piotrcurious/attiny-car-fan-control/Screenshot_2021-04-04-12-01-27-680_com.ecstudiosystems.electriccircuitstudio.jpg

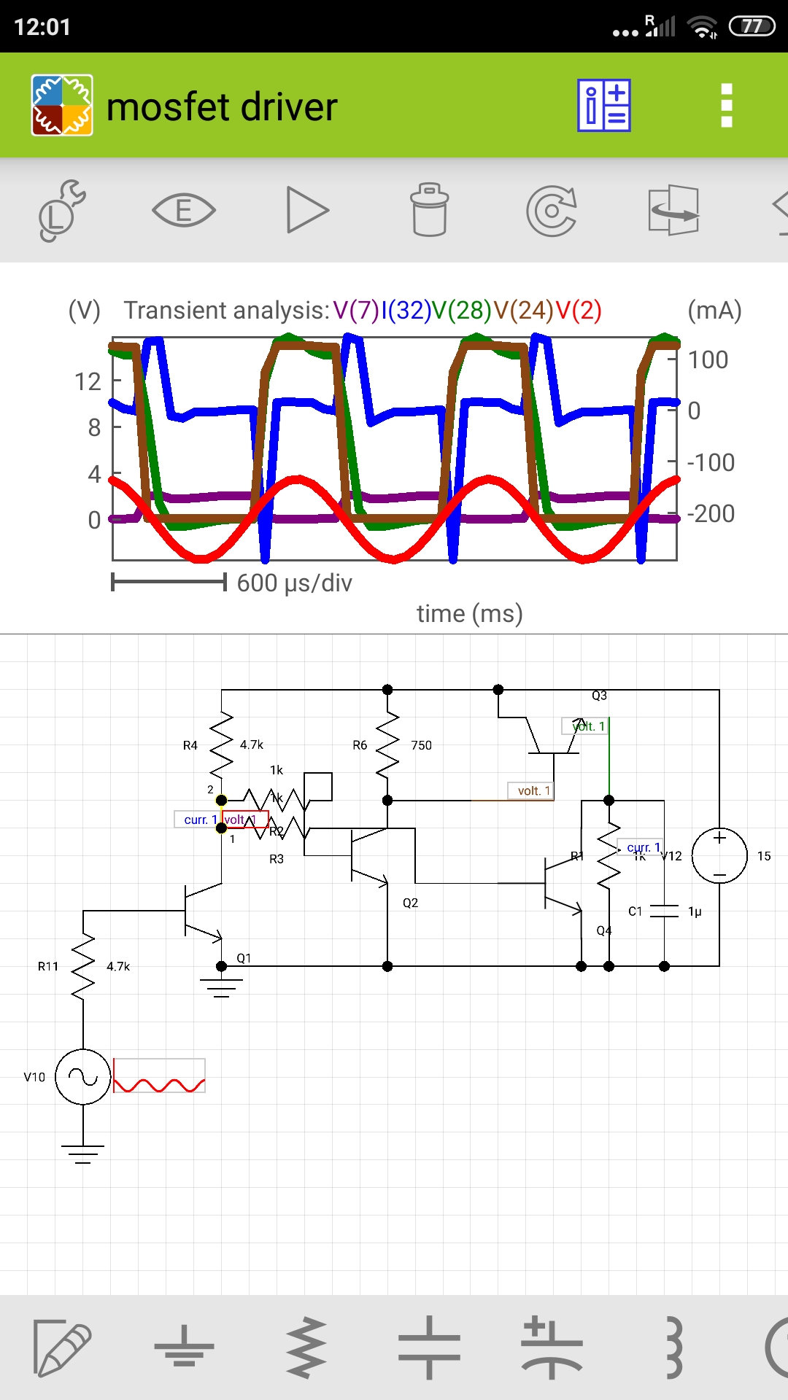
Screenshot_2021-04-04-12-01-27-680_com.ecstudiosystems.electriccircuitstudio.jpg
