piotrcurious/attiny-car-fan-control/(commit log)

2021-06-07 crude mosfet driver
    Crude discrete components mosfet driver, made out of NPN transistors.
    Tested with 12V supply and 10V threshold mosfet.
    It tends to be stable, but must be built quite compact and with decoupling caps and separate ground path to the mosfet to avoid oscillations if supply voltage sags.
    Better using low level mosfet with the driver for more headroom.
    I use it to drive 20A inductive load (fan) with flyback diode mounted on the fan and extra 1000uF on power supply lines made out of several low esr capacitors.
    Driver can be tuned easily by adjusting two resistors driving bases from first amplifer (on the left)
    If using large output transistors, like bd139, this might com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
2022-05-24 New branch with new features
    New features :
    -thermal protector by using NTC thermistor on A3 pin
    -2nd PWM output , it currently outputs battery level to drive analog battery gauge
    -IR serial for debug and remote battery monitoring - too big for attiny13. it could work with attiny85 perhaps?
    -divided output by 4 in software to limit max current. new constant added for global output division.
    [AnalogInOutPWM_thresholds_nonprogrammable_IR_serial_3.ino]
